MetaMobilityLabCMU/Knee-Exoskeleton-Project/Knee_Exo_BOM.xlsx

Part Name | Spec | Type | Quantity | Notes | Name | Unit Price | Quantity | Total | Provider | Link | Part Name
Thigh Bar | PAHT-CF | 3D print | 1 |  | M4 Fastener Kit | 8.39 | 1 | 8.39 | Amazon | https://a.co/d/0dEzoNLS | Mywish 380 Pcs M4 Screw Nuts and Bolts Assortment Kit, 304 Stainless Steel Button Head Socket Cap Metric Screws Bolts, Spring & Flat Lock Washers/Nuts/Hex Wrenches, M4*8/10/12/16/20/25/30
Shank Bar Top | PAHT-CF | 3D print | 1 |  | Standoff Kit | 14.69 | 1 | 14.69 | Amazon | https://a.co/d/0955o79O | HELIFOUNER 242 Pieces M2.5 Male Female Hex Brass Spacers Standoffs Screws Nuts Assortment Kit, Threaded Pillar for Printed Circuit Board Motherboard
Shank Bar Bottom | PAHT-CF | 3D print | 1 |  | PAHT-CF Filament | 94.99 | 2 | 189.98 | Bambu | https://us.store.bambulab.com/products/paht-cf?id=41009450483848 | PAHT-CF, 1kg
Shank Bar Connector | PAHT-CF | 3D print | 1 |  | M3 Motor Fastener | 6.36 | 1 | 6.36 | McMaster | https://www.mcmaster.com/91294A130/ | Black-Oxide Alloy Steel Hex-Drive Flat Head Screw 90 Degree Countersink, M3 x 0.5 mm Thread Size, 10 mm Long
Ankle Bar Slider | PAHT-CF | 3D print | 1 |  |  |  |  |  |  |  |  | Sub Section | Price
Thigh Cuff | PAHT-CF | 3D print | 1 |  |  |  |  |  |  |  |  | Mechanical Total | 219.42
Shank Cuff | PAHT-CF | 3D print | 1 |  | Name | Unit Price | Quantity | Total | Provider | Link | Part Name | Electrical Total | 627.45
Ankle Cuff | PAHT-CF | 3D print | 1 |  | AK80-9 V3 Motor | 579.9 | 1 | 579.9 | CubeMars | https://www.cubemars.com/product/ak80-9-v3-0-robotic-actuator.html | AK80-9 V3.0 KV100 | Low-Level PCB | 47.42
Hex-Drive Flat Head Screw | 90 Degree Countersink, M3 x 0.5 mm Thread Size, 10 mm Long | Fastener | 8 | Motor mount to thigh bar | IMU | 19.95 | 2 | 39.9 | Adafruit | https://www.adafruit.com/product/4554 | Adafruit TDK InvenSense ICM-20948 9-DoF IMU | High-Level PCB | 402.95
Stainless Steel Button Head Hex-Drive Screw | M4 x 0.7 mm Thread Size, 12 mm Long | Fastener | 9 | 3 for cuff, 6 for motor mount to shank bar top | Buck Converter | 7.65 | 1 | 7.65 | Amazon | https://a.co/d/0db9gjQJ | EBOOT 3 Pack MP1584EN DC-DC Buck Converter 24V to 12V 9V 5V 3V Adjustable | Grand Total | 1297.24
Stainless Steel Button Head Hex-Drive Screw | M4 x 0.7 mm Thread Size, 16 mm Long | Fastener | 10 | Cuff to bars | Battery | -
Stainless Steel Button Head Hex-Drive Screw | M4 x 0.7 mm Thread Size, 20 mm Long | Fastener | 3 | Ankle cuff to bar | Emergency Stop (E-STOP)
6061 Aluminum Hex Nuts | M4 x 0.7 mm Thread Size | Fastener | 17 | 16 for cuffs, 1 for ankle adjustment
Clamping Handle with Threaded Stud | M4 x 0.7 mm Size, 15mm Long Thread | Fastener | 1 | Optionally can just be a M4 bolt
Male-Female Threaded Hex Standoff | 4.5mm Hex, 5mm Long, M2.5 x 0.45 mm Thread | Fastener | 3 | PCB standoff
Male-Female Threaded Hex Standoff | 4.5mm Hex, 20mm Long, M2.5 x 0.45 mm Thread | Fastener | 3 | PCB cover standoff
Stainless Steel Pan Head Phillips Screws | M2.5 x 0.45mm Thread, 4mm Long | Fastener | 3 | PCB cover mounting | Name | Unit Price | Quantity | Total | Provider | Link | Part Name
Brass Hex Nut | M2.5 x 0.45 mm Thread | Fastener | 3 | PCB standoff mounting | Teensy 4.1 | 35.95 | 1 | 35.95 | Sparkfun | https://www.sparkfun.com/teensy-4-1-headers.html | Teensy 4.1 (Headers)
IMU | Adafruit TDK InvenSense ICM-20948 9-DoF IMU | PCB | 3 | 2 low-level board, 1 high level board | Shank IMU Board | 7.99 | 1 | 7.99 | Amazon | https://a.co/d/065fXxdn | Solderable Breadboard Mini PCB Board Gold-Plated Solder Breadboard for DIY Electronics Projects Apply to Arduino Soldering Projects 2.0"x1.5" Mixed Color(Pack of 6 Pcs)
CAN Tran | Adafruit CAN Pal - CAN Bus Transceiver - TJA1051T/3 | PCB | 1 | 1 high-level board | CAN Tranciever Chip | 1.74 | 2 | 3.48 | DijiKey | https://www.digikey.com/en/products/detail/nxp-usa-inc/TJA1051T-3-1J/5035822 | TJA1051T/3/1J
CAN Tran Chip | TJA1051T/3/1J | PCB | 2 | used on low-level board
Buck Converter V1 | LM2596 DC to DC Buck Converter 3.0-40V to 1.5-35V Adjustable Voltage Regulator | PCB | 1 | Old buck used on low-level board
Buck Converter V2 | MP1584EN DC-DC Buck Converter | PCB | 2 | New buck used on high and low boards
Jetson Orin Nano | Jetson Orin Nano Super Developer Kit | PCB | 1 | High-level SBC
Teensy 4.1 | PJRC, Sold on Sparkfun | PCB | 1 | Low-level MCU
2 pin connector | Micro JST GH 2Pin 1.25mm | PCB | 5 | 2 for low-level, 3 for high level
XT60 | XT60Connector XT60-M. 2-Pin Male | PCB | 1 | Battery connection to high-level board | Name | Unit Price | Quantity | Total | Provider | Link | Part Name
XT30 2+2 | PCB Connector XT30PB(2+2)-M.G. | PCB | 2 | High-to-low level board PWR connection | CAN PAL | 3.95 | 1 | 3.95 | Adafruit | https://www.adafruit.com/product/5708 | Adafruit CAN Pal - CAN Bus Transceiver - TJA1051T/3
XT30 90 deg | Connector XT30PW30-M.G.* Male Plug Right Angle for RC ESC | PCB | 3 | Low-level board PWR + motor PWR + E-Stop | Jetson | 399 | 1 | 399 | Nvidia | https://marketplace.nvidia.com/en-us/enterprise/robotics-edge/jetson-orin-nano-super-developer-kit/ | Jetson Orin Nano Super Developer Kit
XT30 | Waterproof Connector XT30UW-F.G.Y Female Plug 15A Gold Plated | PCB | 1 | High-level E-Stop Connector | Fuse Holder
Fuse Holder | XFCN PTF-15 | PCB | 1 | Jetson Protection | Fuse
Fuse |  | PCB | 1 | Jetson Protection
Battery | HRB 2packs 6S 22.2V 3300mAh 60C XT60 RC Lipo Battery | Electrical | 1
Emergency Stop (E-STOP) | APIELE 19mm Metal Emergency Stop Push Button | Electrical | 1
Shank IMU cable | 10Gbps 5-Pack Snagless Cat 6 Ethernet Cable, 2ft | Electrical | 1 | Connects low-level board to Shank IMU
Shank IMU board | Solderable Breadboard Mini PCB | Electrical | 1 | Shank IMU board
