MetaMobilityLabCMU/Knee-Exoskeleton-Project/Hardware/STL_Bambu/PCB/Knee_Exo_PCB_Cover_Full.3mf

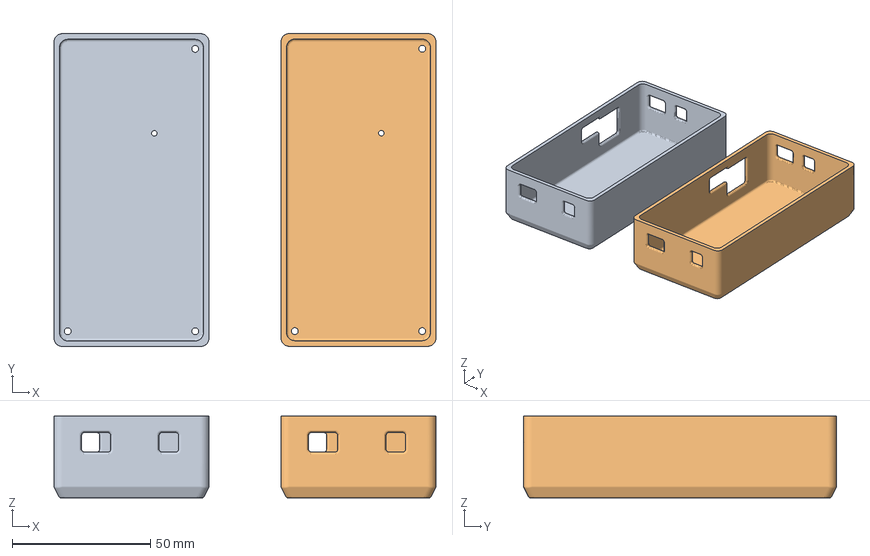
[picture p1: CAD file, 2026-10-26]
Hardware/STL_Bambu/PCB/Knee_Exo_PCB_Cover_Full.3mf
138.0 x 113.1 x 29.6 mm
KneeExo_PCB_Full_Cover.STL x 2
