MetaMobilityLabCMU/Knee-Exoskeleton-Project/Hardware/Solidworks/KneeExo_PCB_Full_Cover.SLDPRT

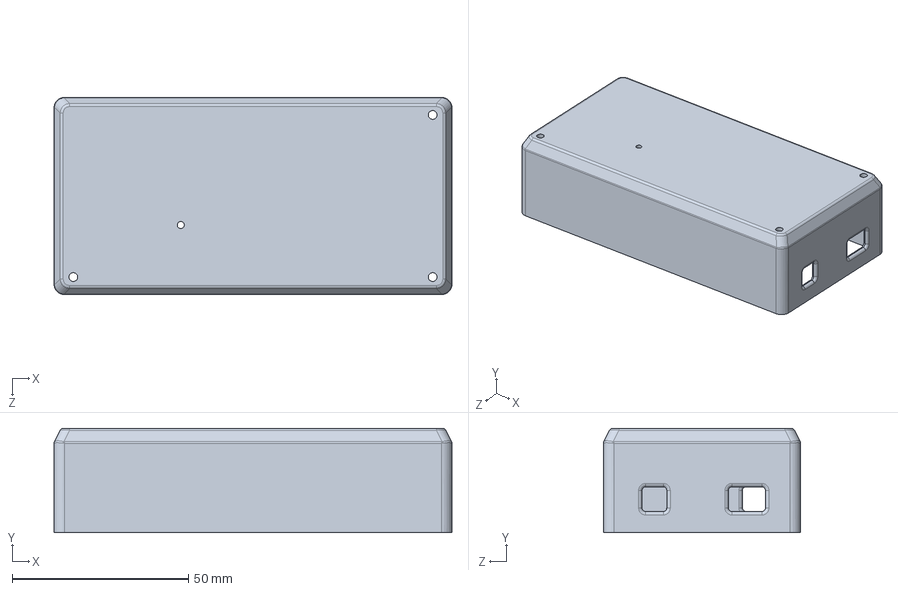
[picture p2: CAD file, 2026-10-26]
Hardware/Solidworks/KneeExo_PCB_Full_Cover.SLDPRT
113.0 x 29.6 x 56.0 mm
