MetaMobilityLabCMU/Knee-Exoskeleton-Project/Hardware/STL_Bambu/Bars/Knee_Exo_Right_Shank_Bar_Connector.STL

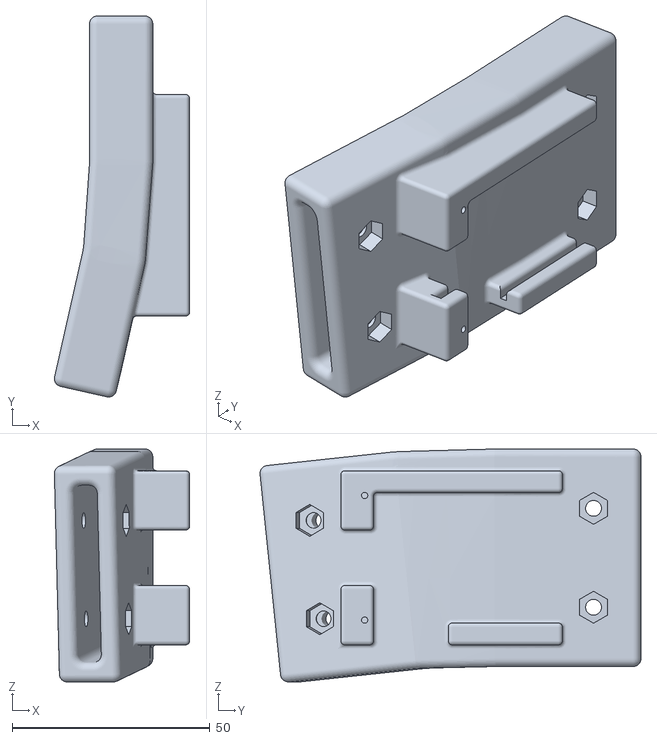
[picture p3: CAD file, 2026-10-26]
Hardware/STL_Bambu/Bars/Knee_Exo_Right_Shank_Bar_Connector.STL
34.2 x 96.3 x 58.9
