MetaMobilityLabCMU/Knee-Exoskeleton-Project/Hardware/STL_Bambu/Cuffs/Knee_Exo_Cuffs_All.3mf

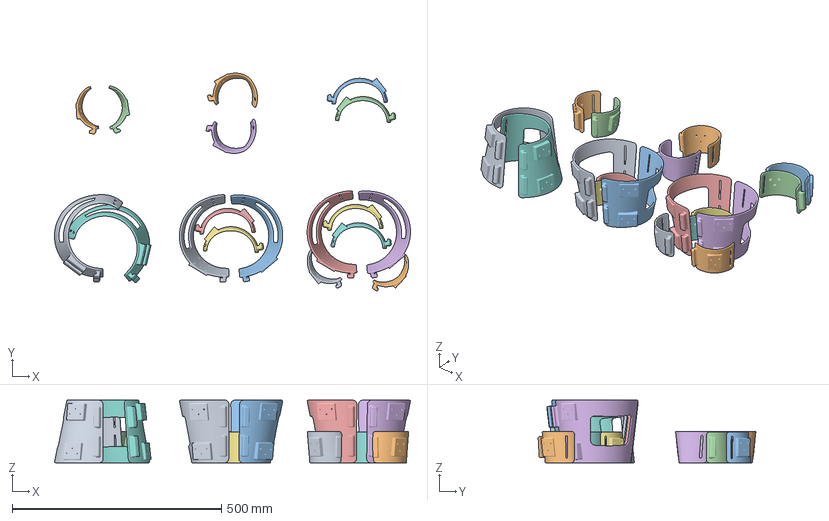
[picture p4: CAD file, 2026-10-26]
Hardware/STL_Bambu/Cuffs/Knee_Exo_Cuffs_All.3mf
851.2 x 520.6 x 149.9 mm
KneeExo_V1_Thigh_Cuff_Right.STL x 6
KneeExo_V1_Ankle_Cuff_Right.STL x 4
Knee_Exo_Right_Shank.STL x 6
KneeExo_V1_Ankle_Cuff_Behind.STL x 2
