MetaMobilityLabCMU/Knee-Exoskeleton-Project/Hardware/STL_Bambu/PCB/Knee_Exo_PCB_Cover_Pins_Exposed.3mf

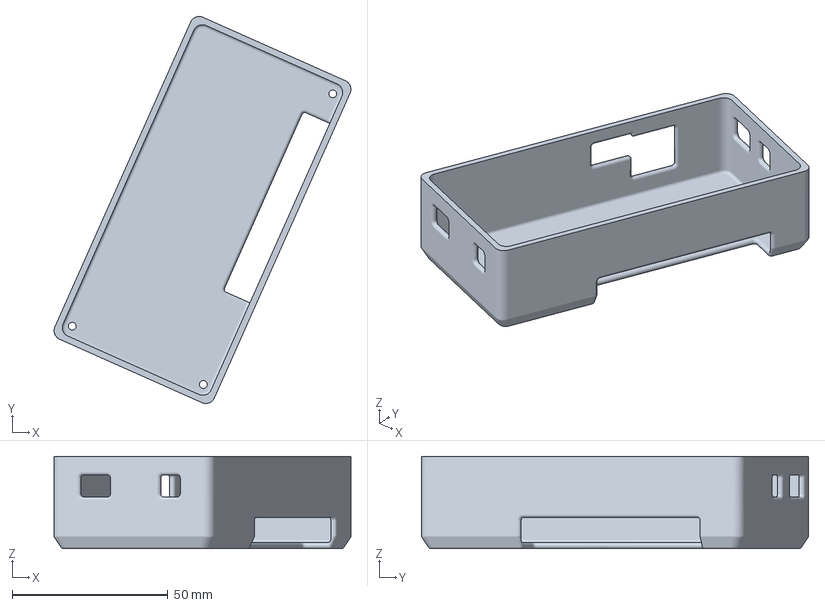
[picture p5: CAD file, 2026-10-26]
Hardware/STL_Bambu/PCB/Knee_Exo_PCB_Cover_Pins_Exposed.3mf
95.2 x 124.1 x 29.6 mm
