MetaMobilityLabCMU/Knee-Exoskeleton-Project/Hardware/STL_Bambu/Bars/KneeExo_V1_Thigh_Bar_long.STL

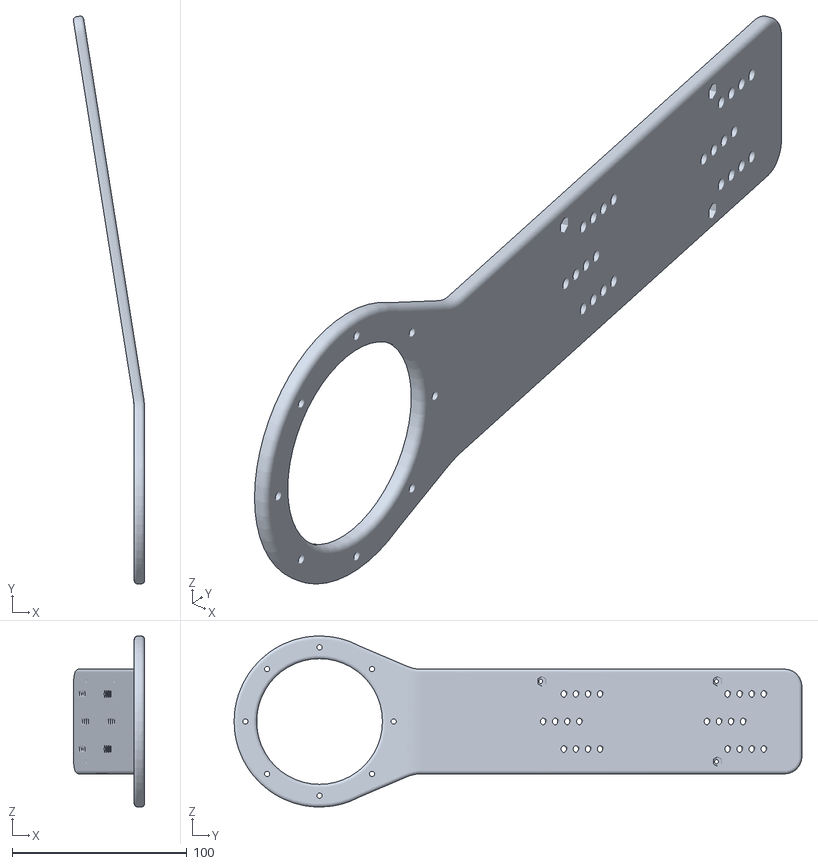
[picture p6: CAD file, 2026-10-26]
Hardware/STL_Bambu/Bars/KneeExo_V1_Thigh_Bar_long.STL
40.9 x 325.4 x 98.0
