MetaMobilityLabCMU/Knee-Exoskeleton-Project/Hardware/STL_Bambu/Cuffs/Knee_Exo_Right_Shank.STL

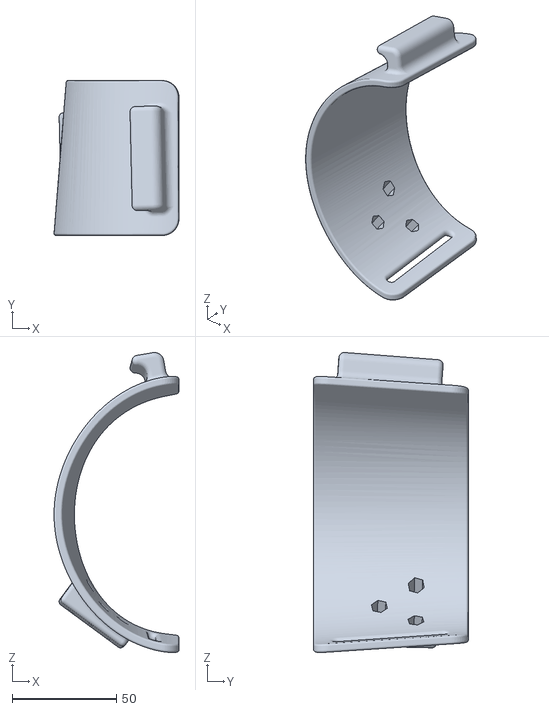
[picture p7: CAD file, 2026-10-26]
Hardware/STL_Bambu/Cuffs/Knee_Exo_Right_Shank.STL
59.8 x 74.2 x 143.7
