MetaMobilityLabCMU/Knee-Exoskeleton-Project/Hardware/Solidworks/KneeExo_V1_Shank_Slide.SLDPRT

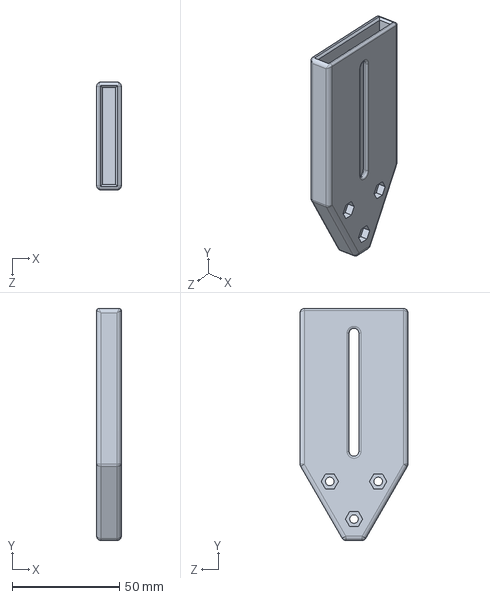
[picture p8: CAD file, 2026-10-26]
Hardware/Solidworks/KneeExo_V1_Shank_Slide.SLDPRT
11.5 x 108.0 x 50.3 mm
