MetaMobilityLabCMU/Knee-Exoskeleton-Project/Hardware/STL_Bambu/Bars/Knee_Exo_Thigh_Bar.STL

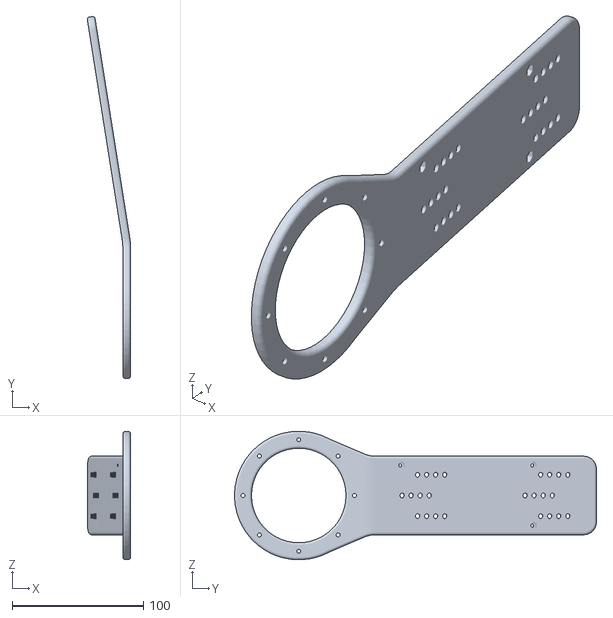
[picture p9: CAD file, 2026-10-26]
Hardware/STL_Bambu/Bars/Knee_Exo_Thigh_Bar.STL
33.1 x 276.0 x 97.9
