MetaMobilityLabCMU/Knee-Exoskeleton-Project/Hardware/STL_Bambu/Cuffs/Knee_Exo_Right_Ankle_Behind.STL

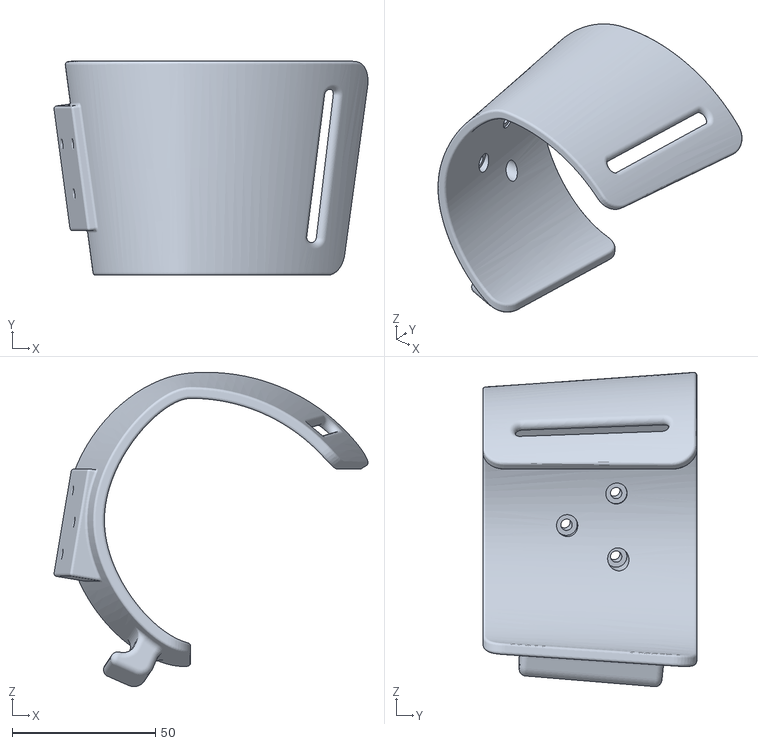
[picture p10: CAD file, 2026-10-26]
Hardware/STL_Bambu/Cuffs/Knee_Exo_Right_Ankle_Behind.STL
109.7 x 74.9 x 109.8
