MetaMobilityLabCMU/Knee-Exoskeleton-Project/Hardware/STL_Bambu/Cuffs/Knee_Exo_Right_Thigh.STL

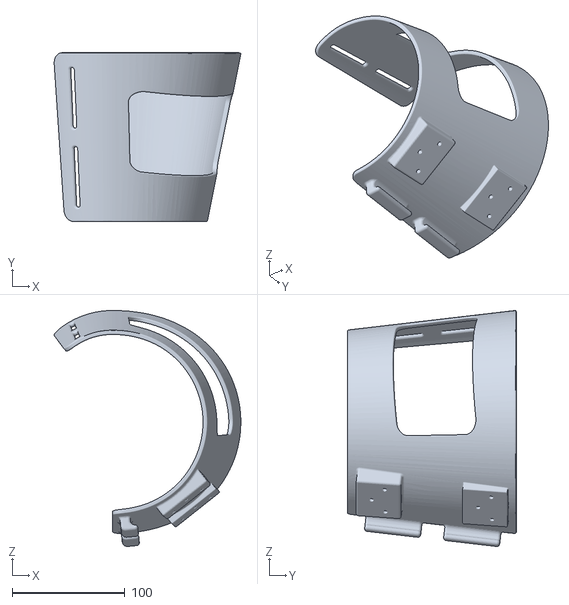
[picture p11: CAD file, 2026-10-26]
Hardware/STL_Bambu/Cuffs/Knee_Exo_Right_Thigh.STL
165.4 x 149.9 x 209.1
