MetaMobilityLabCMU/Knee-Exoskeleton-Project/Hardware/Solidworks/KneeExo_V1_Thigh_Cuff_Curvature_Itterations.SLDPRT

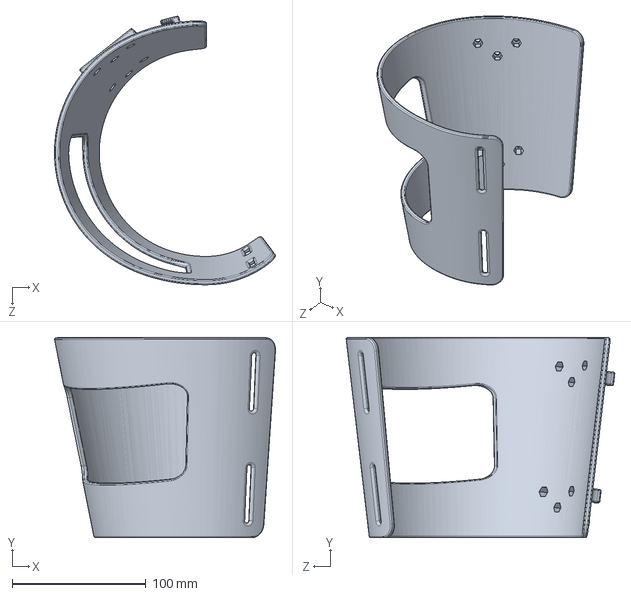
[picture p12: CAD file, 2026-10-26]
Hardware/Solidworks/KneeExo_V1_Thigh_Cuff_Curvature_Itterations.SLDPRT
165.4 x 149.9 x 201.0 mm
