MetaMobilityLabCMU/Knee-Exoskeleton-Project/Hardware/STL_Bambu/Bars/Knee_Exo_Right_Shank_Bar_Top.STL

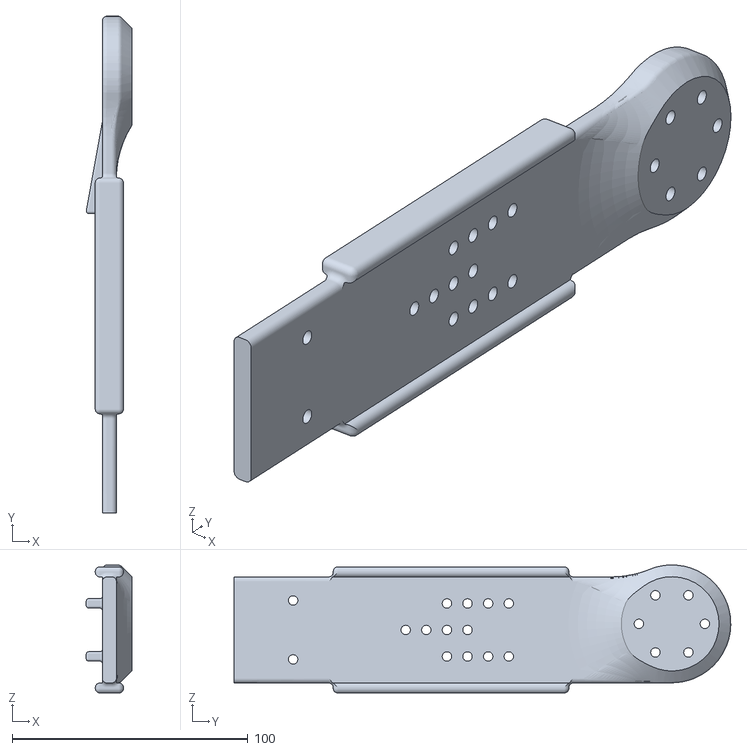
[picture p13: CAD file, 2026-10-26]
Hardware/STL_Bambu/Bars/Knee_Exo_Right_Shank_Bar_Top.STL
19.3 x 210.7 x 54.3
