MetaMobilityLabCMU/Knee-Exoskeleton-Project/Hardware/STL_Bambu/Cuffs/Knee_Exo_Right_Ankle.STL

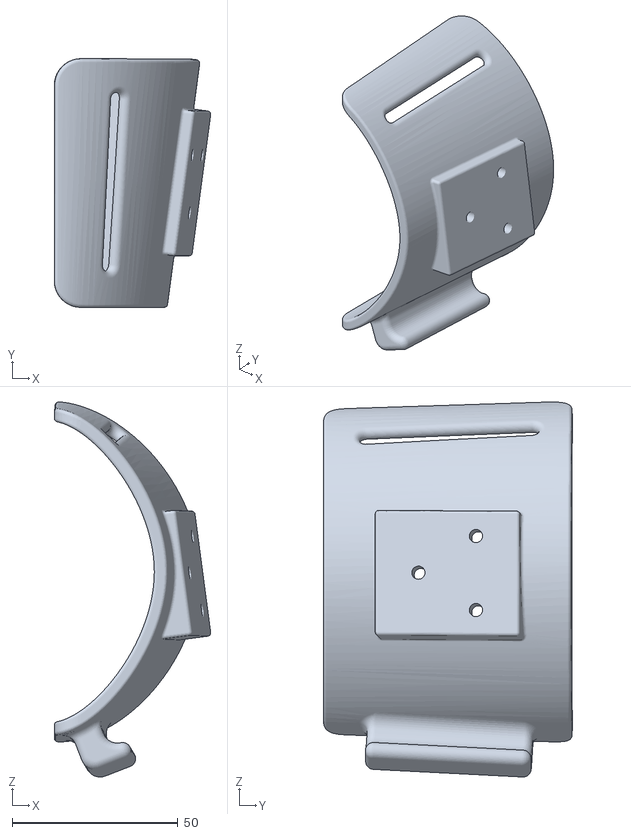
[picture p14: CAD file, 2026-10-26]
Hardware/STL_Bambu/Cuffs/Knee_Exo_Right_Ankle.STL
47.2 x 75.0 x 113.0
