MetaMobilityLabCMU/Knee-Exoskeleton-Project/Hardware/STL_Bambu/Bars/Knee_Exo_Right_Shank_Bar_Bottom.STL

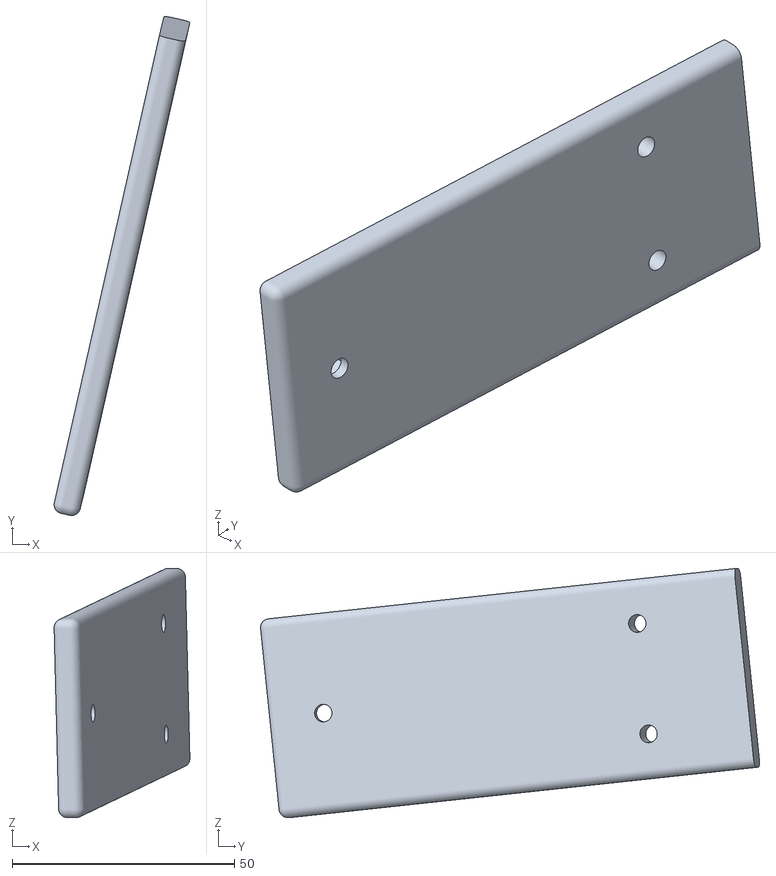
[picture p15: CAD file, 2026-10-26]
Hardware/STL_Bambu/Bars/Knee_Exo_Right_Shank_Bar_Bottom.STL
30.6 x 112.4 x 56.1
