MetaMobilityLabCMU/Knee-Exoskeleton-Project/Hardware/STL_Bambu/Bars/Knee_Exo_Bars_All.3mf

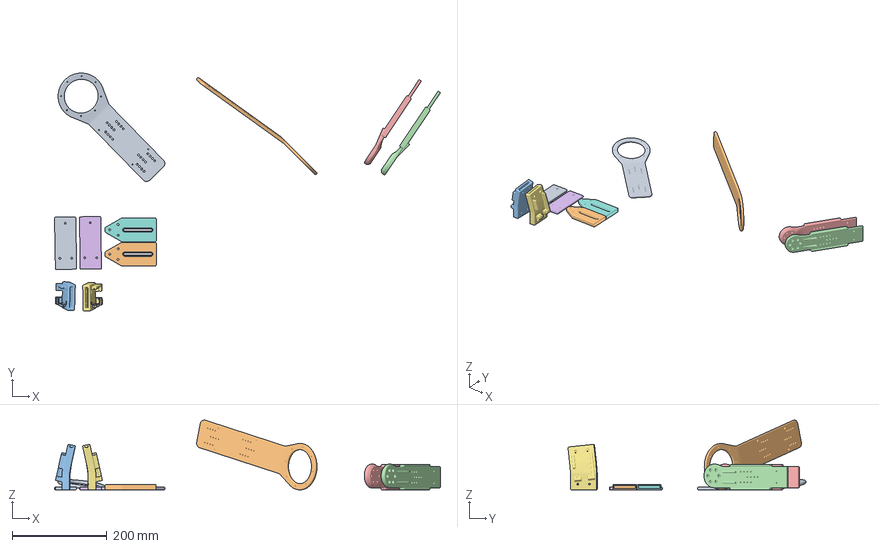
[picture p16: CAD file, 2026-10-26]
Hardware/STL_Bambu/Bars/Knee_Exo_Bars_All.3mf
815.2 x 502.4 x 147.2 mm
Knee_Exo_Right_Shank_Bar_Bottom.STL x 2
KneeExo_V1_Thigh_Bar_long.STL
Knee_Exo_Right_Shank_Bar_Connector.STL x 2
Knee_Exo_Right_Shank_Bar_Top.STL x 2
Knee_Exo_Shank_Slide.STL x 2
Knee_Exo_Thigh_Bar.STL
