MetaMobilityLabCMU/Knee-Exoskeleton-Project/Hardware/Solidworks/AK80-9 V3.0.STEP

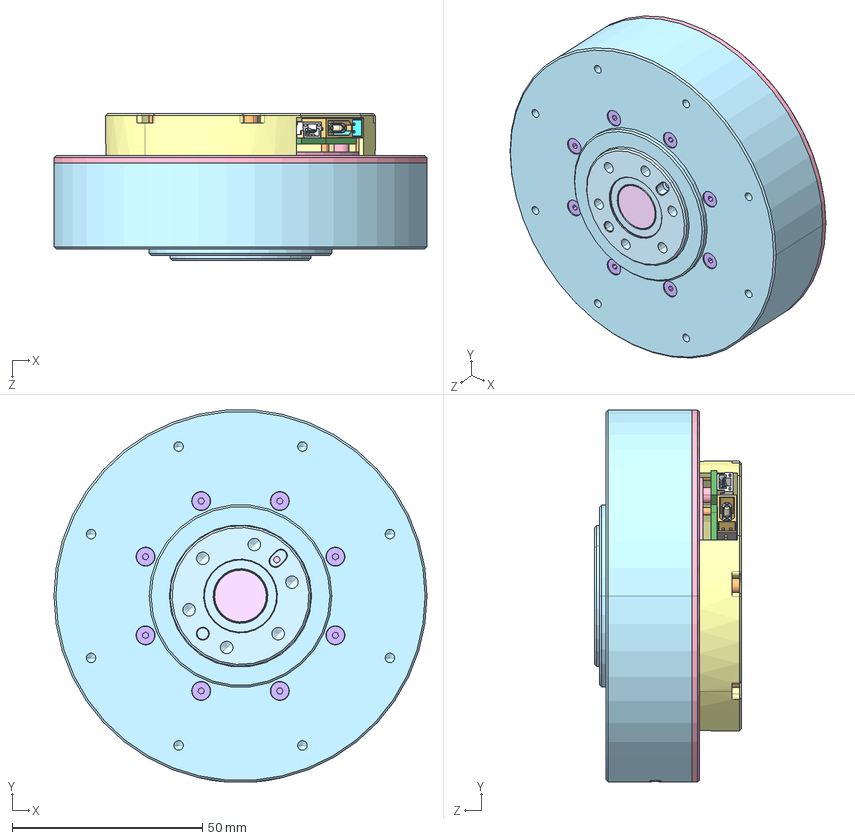
[picture p18: CAD file, 2026-10-26]
Hardware/Solidworks/AK80-9 V3.0.STEP
98.0 x 97.7 x 38.5 mm
AK80-9怮栠謫-2
C0105000046-国产-6701-ZZ轴承 x 2
C0103000453-感应磁铁
AK80-9输入轴-2
AK80-9下行星架
C0105000059-EZO-625-ZZ粣創
C0105000031-国产-6707-ZZ轴承
AK80-9猾敕裔
AK80-9儂褲
AK80-9綴儂褲
C0203000297-M2.5×6沉头内六角螺钉 x 24
C0203000308-M2X12 x 6
BZD02010008-驱动板(C-AK-DRV-12S_V3.00_L)-2
BJJ02040285-AK80-9驱动盖板-V3.0
