MetaMobilityLabCMU/Knee-Exoskeleton-Project/Hardware/Solidworks/KneeExo_V1_Strap_Tab.SLDPRT

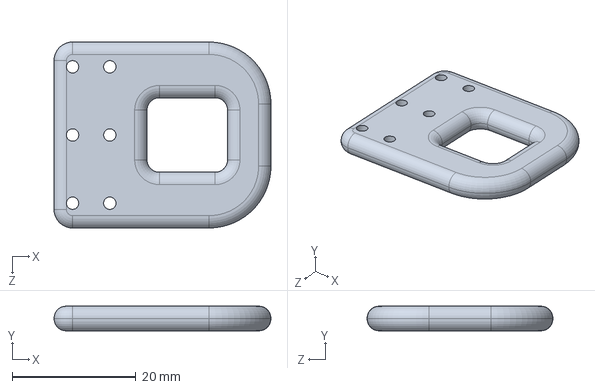
[picture p19: CAD file, 2026-10-26]
Hardware/Solidworks/KneeExo_V1_Strap_Tab.SLDPRT
35.0 x 4.00 x 30.0 mm
