MetaMobilityLabCMU/Knee-Exoskeleton-Project/Hardware/Solidworks/Knee_PCB_Layout.step

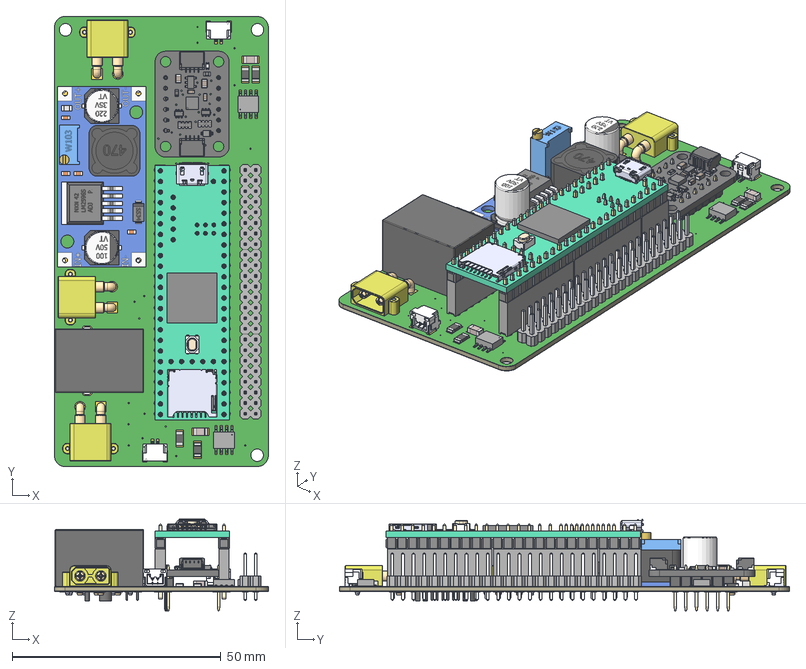
[picture p20: CAD file, 2026-10-26]
Hardware/Solidworks/Knee_PCB_Layout.step
51.3 x 108.0 x 22.0 mm
