MetaMobilityLabCMU/Knee-Exoskeleton-Project/Hardware/Solidworks/KneeExo_V1_Shank_Bar.SLDPRT

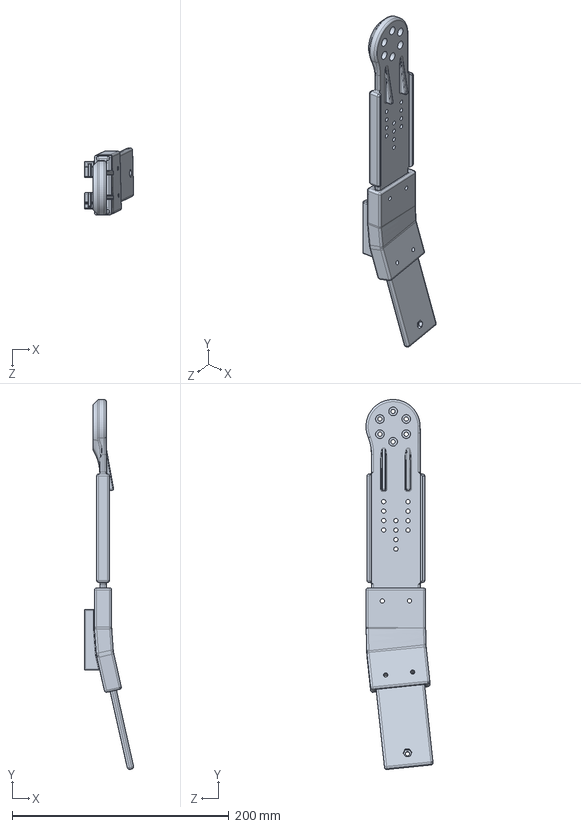
[picture p21: CAD file, 2026-10-26]
Hardware/Solidworks/KneeExo_V1_Shank_Bar.SLDPRT
45.6 x 341.2 x 61.8 mm
