MetaMobilityLabCMU/Knee-Exoskeleton-Project/(list of files, cad)

Other CAD files:
Hardware/Solidworks/KneeExo_V1_Assembly.SLDASM
Hardware/Solidworks/testing_match.SLDASM
Hardware/STL_Bambu/Bars/Knee_Exo_Shank_Slide.STL
Hardware/Solidworks/KneeExo_V1_Ankle_Cuff_Behind.SLDPRT
Hardware/Solidworks/KneeExo_V1_Thigh_Bar_long.SLDPRT
Hardware/Solidworks/KneeExo_V1_Thigh_Cuff.SLDPRT
Hardware/Solidworks/KneeExo_V1_Ankle_Cuff.SLDPRT
Hardware/Solidworks/KneeExo_V1_Thigh_Bar.SLDPRT
Hardware/Solidworks/KneeExo_V1_Shank_Cuff.SLDPRT
Hardware/STL_Bambu/PCB/Knee_Exo_PCB_Cover_Full.STL
Hardware/STL_Bambu/PCB/Knee_Exo_PCB_Cover_Pins_Exposed.STL
Hardware/Solidworks/5720K28_Clamping Handle with Threaded Stud.SLDPRT
Hardware/Solidworks/90690A035_Brass Hex Nut_M2.5.SLDPRT
Hardware/Solidworks/91294A130_Black-Oxide Alloy Steel Hex Drive Flat Head Screw.SLDPRT
Hardware/Solidworks/92000A102_Passivated 18-8 Stainless Steel Pan Head Phillips Screws_M2_5x4.SLDPRT
Hardware/Solidworks/92095A192_Button Head Hex Drive Screw_M4x12.SLDPRT
Hardware/Solidworks/92095A194_Button Head Hex Drive Screw_M4x16.SLDPRT
Hardware/Solidworks/92095A478_Button Head Hex Drive Screw_M4x18.SLDPRT
Hardware/Solidworks/93800A127_Nylon Hex Nut_M4.SLDPRT
Hardware/Solidworks/98952A101_Aluminum Male-Female Threaded Hex Standoff_M4x5.SLDPRT
Hardware/Solidworks/98952A117_Aluminum Male-Female Threaded Hex Standoff_M4x20.SLDPRT
