MetaMobilityLabCMU/Knee-Exoskeleton-Project/(commit log)

2026-11-01 Track .glb files with Git LFS
2026-11-03 updated BOM
2026-11-03 added PDF BOM
2026-11-04 added Low-Level PCB
